zk-phi/pollux-keyboard/(commit log)

2019-02-12 Move ProMicro position (1)
    [switch42.kicad_pcb]
2019-02-12 Remove redundant wire
    [switch42.kicad_pcb, switch42.sch]
2019-02-14 Update case model
    [pollux.scad]
2019-02-14 Update preview model
    [pollux.scad]
2019-02-14 Move TRRS and reset sw / complete wiring
    [switch42.kicad_pcb, switch42.sch]
2019-02-14 Add screws
    [pollux.scad]
2019-02-14 Refactoring: Use constant instead of a magic number
    [pollux.scad]
2019-02-14 Apply kadomaru to promicro contact of the bottomplate
    [pollux.scad]
2019-02-14 Add laser cut model / refactor preview model slightly
    [pollux.scad]
2019-02-14 Make cut model smaller
    [pollux.scad]
2021-07-02 Add icon
    [switch42.kicad_pcb]
2021-07-02 Replace choc footprint with my own one
    [switch42.kicad_pcb, switch42.sch]
2021-07-02 Slightly adjust outer shape
    [pollux.scad, switch42.kicad_pcb]
2021-07-02 Fix case right-hand-side case model
    [pollux.scad]
2021-07-02 Refactoring: Remove unused spacer preview models
    [pollux.scad]
2021-07-02 Fix plate thickness
    [pollux.scad]
2021-07-02 Remove all vias and wires
    [switch42.kicad_pcb]
2021-07-02 Add a screw hole
    [pollux.scad]
2021-07-02 Change and rearrange footprints
    [switch42.kicad_pcb, switch42.sch]
2021-07-02 Fix screw position computation
    [pollux.scad]
2021-07-02 Move dimensions
    [switch42.kicad_pcb]
2021-07-02 Update case preview model
    [pollux.scad]
2021-07-02 Add pcb_slop to wall_thickness
    [pollux.scad]
2021-07-02 Move SMD diodes
    [switch42.kicad_pcb]
2021-07-02 Add SK6812minis for backlight
    [switch42.kicad_pcb, switch42.sch]
2021-07-02 Add slop
    [pollux.scad]
2021-07-02 Remove completed todo
    [pollux.scad]
2021-07-02 Add variable to control thumb margin
    [pollux.scad]
2021-07-02 Update cut model
    [pollux.scad]
2021-07-02 Adjust logo position and add revision number
    [switch42.kicad_pcb]
2021-07-02 Add variable kadomaru_r
    [pollux.scad]
2021-07-02 Add underglow leds
    [switch42.kicad_pcb, switch42.sch]
2021-07-02 Make thumb clusters strippable
    [switch42.kicad_pcb]
2021-07-02 Update footprints
    [switch42.kicad_pcb]
2021-07-02 Remove some underglow LEDs and reorientate
    [switch42.kicad_pcb, switch42.sch]
2021-07-02 Change footprints and add trivial wires
    [switch42.kicad_pcb, switch42.sch]
2021-07-02 Wires tmp
    [switch42.kicad_pcb, switch42.sch]
2021-07-02 Complete wiring, turn 1.25u into 1u
    [switch42.kicad_pcb, switch42.sch]
2021-07-02 Add TODO comment
    [pollux.scad]
2021-07-02 Update dimensions
    [switch42.kicad_pcb]
2021-07-02 Use 1u instead of 1.25u
    [pollux.scad]
2021-07-02 Add another gate
    [switch42.kicad_pcb]
2021-07-02 Update print model
    [pollux.scad]
2021-07-02 Add comment
    [pollux.scad]
2021-07-02 Fix missing wire
    [switch42.kicad_pcb, switch42.sch]
2021-07-02 Add led order image (#2)
2021-07-02 Mention about another case variation
2021-07-02 Fix middleframe models
    [pollux.scad]
2021-07-02 Add 2-mm-only cut models
    [pollux.scad]
